Mustafa0812/Sesame/docs/README.md

# Documentation

| Folder / file | Contents |
|---|---|
| [build-guide/](build-guide/README.md) | Step-by-step mechanical assembly with photos (upstream Sesame) |
| [wiring-guide/](wiring-guide/README.md) | Wiring diagrams for the S2 Mini and Distro Board builds (upstream Sesame) |
| [motor-testing/](motor-testing/README.md) | Testing each servo and calibrating the hip joints before final assembly |
| [esp32-s3-supermini/](esp32-s3-supermini/README.md) | Porting notes for the ESP32-S3 SuperMini used by the two-bot setup: corrected pinout, calibration, bench findings |
| [images/](images/) | Project photos, face renders, and the ground-station dashboard screenshot (`images/two-bot/`) |
| [Sesame-Robots.pdf](Sesame-Robots.pdf) | Project write-up: two Sesame robots as communicating state machines |
