Mustafa0812/Sesame/docs/images/two-bot/before-head-extension.jpeg

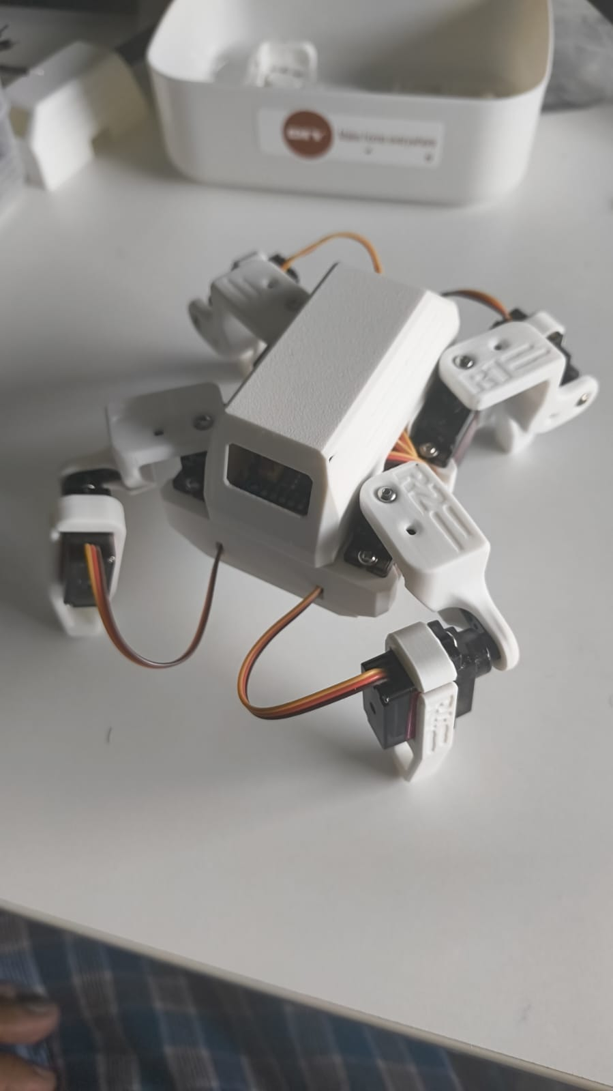
docs/images/two-bot/before-head-extension.jpeg
