Mustafa0812/Sesame/docs/images/two-bot/wiring-dilemma.jpeg

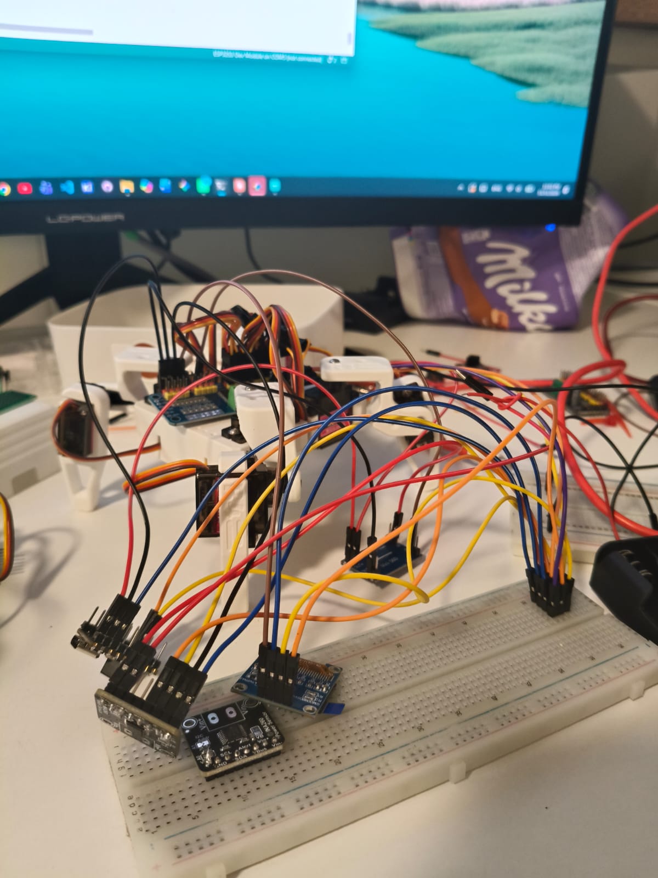
docs/images/two-bot/wiring-dilemma.jpeg
