Mustafa0812/Sesame/firmware/sesame-firmware-main/movement-sequences.h

#pragma once

#include <Arduino.h>

enum ServoName : uint8_t {
  R1 = 0, 
  R2 = 1,
  L1 = 2,
  L2 = 3,
  R3 = 4,
  R4 = 5,
  L4 = 6,
  L3 = 7
};

const String ServoNames[]={"R1","R2","L1","L2","R3","R4","L4","L3"};

inline int servoNameToIndex(const String& servo) {
  if (servo == "L1") return L1;
  if (servo == "L2") return L2;
  if (servo == "L3") return L3;
  if (servo == "L4") return L4;
  if (servo == "R1") return R1;
  if (servo == "R2") return R2;
  if (servo == "R3") return R3;
  if (servo == "R4") return R4;
  return -1;
}

enum FaceAnimMode : uint8_t {
  FACE_ANIM_LOOP = 0,
  FACE_ANIM_ONCE = 1,
  FACE_ANIM_BOOMERANG = 2
};

// External globals and helpers used by movement/pose sequences
extern int frameDelay;
extern int walkCycles;
extern String currentCommand;

extern void setServoAngle(uint8_t channel, int angle);
extern void setFace(const String& faceName);
extern void setFaceMode(FaceAnimMode mode);
extern void setFaceWithMode(const String& faceName, FaceAnimMode mode);
extern void delayWithFace(unsigned long ms);
extern void enterIdle();
extern bool pressingCheck(String cmd, int ms);

// Pose/animation prototypes
void runRestPose();
void runStandPose(int face = 1);
void runWavePose();
void runDancePose();
void runSwimPose();
void runPointPose();
void runPushupPose();
void runBowPose();
void runCutePose();
void runFreakyPose();
void runWormPose();
void runShakePose();
void runShrugPose();
void runDeadPose();
void runCrabPose();
void runWalkPose();
void runWalkBackward();
void runTurnLeft();
void runTurnRight();

// ====== POSES ======
inline void runRestPose() { 
  Serial.println(F("REST")); 
  setFaceWithMode("rest", FACE_ANIM_BOOMERANG); 
  for (int i = 0; i < 8; i++) setServoAngle(i, 90); 
}

inline void runStandPose(int face) { 
  Serial.println(F("STAND")); 
  if (face == 1) setFaceWithMode("stand", FACE_ANIM_ONCE); 
  setServoAngle(R1, 135); 
  setServoAngle(R2, 45); 
  setServoAngle(L1, 45); 
  setServoAngle(L2, 135); 
  setServoAngle(R3, 0); 
  setServoAngle(R4, 180); 
  setServoAngle(L4, 0); 
  setServoAngle(L3, 180); 
  if (face == 1) enterIdle();
}

inline void runWavePose() { 
  Serial.println(F("WAVE")); 
  setFaceWithMode("wave", FACE_ANIM_ONCE); 
  runStandPose(0); 
  delayWithFace(200);
  setServoAngle(L3, 100); setServoAngle(R4, 0);   // R4 waves, L3 holds one position
  setServoAngle(L2, 90); // R1 stays in the stand pose (was: setServoAngle(R1, 100))
  delayWithFace(200);
  setServoAngle(R4, 0);
  delayWithFace(300);
  for (int i = 0; i < 4; i++) {
    setServoAngle(R4, 0); delayWithFace(300);
    setServoAngle(R4, 80); delayWithFace(300);
  }
  runStandPose(1); 
  if (currentCommand == "wave") currentCommand = "";
}

inline void runDancePose() { 
  Serial.println(F("DANCE")); 
  setFaceWithMode("dance", FACE_ANIM_LOOP); 
  setServoAngle(R1, 90); setServoAngle(R2, 90); 
  setServoAngle(L1, 90); setServoAngle(L2, 90); 
  setServoAngle(R3, 160); setServoAngle(R4, 160); 
  setServoAngle(L4, 10); setServoAngle(L3, 10); 
  delayWithFace(300); 
  for (int i = 0; i < 5; i++) { 
    setServoAngle(R3, 115); setServoAngle(R4, 115); 
    setServoAngle(L4, 10); setServoAngle(L3, 10); 
    delayWithFace(300); 
    setServoAngle(R3, 160); setServoAngle(R4, 160); 
    setServoAngle(L4, 65); setServoAngle(L3, 65); 
    delayWithFace(300); 
  } 
  runStandPose(1); 
  if (currentCommand == "dance") currentCommand = "";
}

inline void runSwimPose() { 
  Serial.println(F("SWIM")); 
  setFaceWithMode("swim", FACE_ANIM_ONCE); 
  for (int i = 0; i < 8; i++) setServoAngle(i, 90); 
  for (int i = 0; i < 4; i++) { 
    setServoAngle(R1, 135); setServoAngle(R2, 45); 
    setServoAngle(L1, 45); setServoAngle(L2, 135); 
    delayWithFace(400); 
    setServoAngle(R1, 90); setServoAngle(R2, 90); 
    setServoAngle(L1, 90); setServoAngle(L2, 90); 
    delayWithFace(400); 
  } 
  runStandPose(1); 
  if (currentCommand == "swim") currentCommand = "";
}

inline void runPointPose() { 
  Serial.println(F("POINT")); 
  setFaceWithMode("point", FACE_ANIM_BOOMERANG); 
  setServoAngle(L2, 90); setServoAngle(R1, 135); 
  setServoAngle(R2, 100); setServoAngle(L3, 180); 
  setServoAngle(L1, 25); setServoAngle(L4, 145);
  setServoAngle(R3, 80); setServoAngle(R4, 170); 
  delayWithFace(2000); 
  runStandPose(1); 
  if (currentCommand == "point") currentCommand = "";
}

inline void runPushupPose() {
  Serial.println(F("PUSHUP"));
  setFaceWithMode("pushup", FACE_ANIM_ONCE);
  runStandPose(0); 
  delayWithFace(200);
  setServoAngle(L1, 0);
  setServoAngle(R1, 180);
  setServoAngle(R3, 90);
  setServoAngle(R4, 90);
  delayWithFace(500);
  for (int i = 0; i < 4; i++) {
    setServoAngle(R3, 0);
    setServoAngle(R4, 180);
    delayWithFace(600);
    setServoAngle(R3, 90);
    setServoAngle(R4, 90);
    delayWithFace(500);
  }
  runStandPose(1);
  if (currentCommand == "pushup") currentCommand = "";
}

inline void runBowPose() {
  Serial.println(F("BOW"));
  setFaceWithMode("bow", FACE_ANIM_ONCE);
  runStandPose(0); 
  delayWithFace(200);
  setServoAngle(L1, 0);
  setServoAngle(R1, 180);
  setServoAngle(L4, 0);
  setServoAngle(R4, 180);
  setServoAngle(L2, 180);
  setServoAngle(R2, 0);
  setServoAngle(R3, 0);
  setServoAngle(L3, 180);
  delayWithFace(600);
  setServoAngle(L4, 90);
  setServoAngle(R4, 90);
  delayWithFace(3000);
  runStandPose(1);
  if (currentCommand == "bow") currentCommand = "";
}

inline void runCutePose() {
  Serial.println(F("CUTE"));
  setFaceWithMode("cute", FACE_ANIM_ONCE);
  runStandPose(0); 
  delayWithFace(200);
  setServoAngle(L2, 160);
  setServoAngle(R2, 20);
  setServoAngle(R3, 180);
  setServoAngle(L3, 0);

  setServoAngle(L1, 0);
  setServoAngle(R1, 180);
  setServoAngle(L4, 180);
  setServoAngle(R4, 0);
  delayWithFace(200);
  for (int i = 0; i < 5; i++) {
    setServoAngle(R3, 180);
    setServoAngle(L3, 45);
    delayWithFace(300);
    setServoAngle(R3, 135);
    setServoAngle(L3, 0);
    delayWithFace(300);
  }
  runStandPose(1);
  if (currentCommand == "cute") currentCommand = "";
}

inline void runFreakyPose() {
  Serial.println(F("FREAKY"));
  setFaceWithMode("freaky", FACE_ANIM_ONCE);
  runStandPose(0); 
  delayWithFace(200);
  setServoAngle(L1, 0);
  setServoAngle(R1, 180);
  setServoAngle(L2, 180);
  setServoAngle(R2, 0);
  setServoAngle(R3, 90);
  setServoAngle(R4, 0);
  delayWithFace(200);
  for (int i = 0; i < 3; i++) {
    setServoAngle(R4, 25);
    delayWithFace(400);
    setServoAngle(R4, 0);
    delayWithFace(400);
  }
  runStandPose(1);
  if (currentCommand == "freaky") currentCommand = "";
}

inline void runWormPose() {
  Serial.println(F("WORM"));
  setFaceWithMode("worm", FACE_ANIM_ONCE);
  runStandPose(0);
  delayWithFace(200);
  setServoAngle(R1, 180); setServoAngle(R2, 0); setServoAngle(L1, 0); setServoAngle(L2, 180);
  setServoAngle(R3, 90); setServoAngle(R4, 90); setServoAngle(L4, 90); setServoAngle(L3, 90);
  delayWithFace(200);
  for(int i=0; i<5; i++) {
    setServoAngle(R4, 45); setServoAngle(L4, 135); setServoAngle(R3, 45); setServoAngle(L3, 135);
    delayWithFace(300);
    setServoAngle(R4, 135); setServoAngle(L4, 45); setServoAngle(R3, 135); setServoAngle(L3, 45);
    delayWithFace(300);
  }
  runStandPose(1);
  if (currentCommand == "worm") currentCommand = "";
}

inline void runShakePose() {
  Serial.println(F("SHAKE"));
  setFaceWithMode("shake", FACE_ANIM_ONCE);
  runStandPose(0);
  delayWithFace(200);
  setServoAngle(R1, 135); setServoAngle(L1, 45); setServoAngle(L4, 90); setServoAngle(R4, 90);
  setServoAngle(L2, 90); setServoAngle(R2, 90);
  delayWithFace(200);
  for(int i=0; i<5; i++) {
    setServoAngle(R3, 45); setServoAngle(L3, 135);
    delayWithFace(300);
    setServoAngle(R3, 0); setServoAngle(L3, 180);
    delayWithFace(300);
  }
  runStandPose(1);
  if (currentCommand == "shake") currentCommand = "";
}

inline void runShrugPose() {
  Serial.println(F("SHRUG"));
  runStandPose(0);
  setFaceWithMode("dead", FACE_ANIM_ONCE);
  delayWithFace(200);
  setServoAngle(R4, 90); setServoAngle(R3, 90); setServoAngle(L4, 90); setServoAngle(L3, 90);
  delayWithFace(1000);
  setFaceWithMode("shrug", FACE_ANIM_ONCE);
  setServoAngle(R4, 0); setServoAngle(R3, 180); setServoAngle(L4, 180); setServoAngle(L3, 0);
  delayWithFace(1500);
  runStandPose(1);
  if (currentCommand == "shrug") currentCommand = "";
}

inline void runDeadPose() {
  Serial.println(F("DEAD"));
  runStandPose(0);
  setFaceWithMode("dead", FACE_ANIM_BOOMERANG);
  delayWithFace(200);
  setServoAngle(R4, 90); setServoAngle(R3, 90); setServoAngle(L4, 90); setServoAngle(L3, 90);
  if (currentCommand == "dead") currentCommand = "";
}

inline void runCrabPose() {
  Serial.println(F("CRAB"));
  setFaceWithMode("crab", FACE_ANIM_ONCE);
  runStandPose(0);
  delayWithFace(200);
  setServoAngle(R1, 90); setServoAngle(R2, 90); setServoAngle(L1, 90); setServoAngle(L2, 90);
  setServoAngle(R3, 0); setServoAngle(R4, 180); setServoAngle(L4, 45); setServoAngle(L3, 135);
  for(int i=0; i<5; i++) {
    setServoAngle(R3, 45); setServoAngle(R4, 135); setServoAngle(L4, 0); setServoAngle(L3, 180);
    delayWithFace(300);
    setServoAngle(R3, 0); setServoAngle(R4, 180); setServoAngle(L4, 45); setServoAngle(L3, 135);
    delayWithFace(300);
  }
  runStandPose(1);
  if (currentCommand == "crab") currentCommand = "";
}

// --- MOVEMENT ANIMATIONS ---
inline void runWalkBackward() {
  Serial.println(F("WALK BACK"));
  setFaceWithMode("walk", FACE_ANIM_ONCE);
  // Initial Step
  setServoAngle(R4, 135); setServoAngle(L4, 45);
  setServoAngle(R2, 100); setServoAngle(L1, 25);
  if (!pressingCheck("backward", frameDelay)) return;
  
  for (int i = 0; i < walkCycles; i++) {
    setServoAngle(R4, 135); setServoAngle(L4, 0);
    if (!pressingCheck("backward", frameDelay)) return;
    setServoAngle(L3, 135); setServoAngle(L2, 90);
    setServoAngle(R3, 0); setServoAngle(R1, 180);
    if (!pressingCheck("backward", frameDelay)) return;    
    setServoAngle(R2, 45); setServoAngle(L1, 90);
    if (!pressingCheck("backward", frameDelay)) return;
    setServoAngle(R3, 45); setServoAngle(L3, 180);
    if (!pressingCheck("backward", frameDelay)) return;
    setServoAngle(R4, 180); setServoAngle(L4, 45);
    setServoAngle(R2, 90); setServoAngle(L1, 0);
    if (!pressingCheck("backward", frameDelay)) return;  
    setServoAngle(L2, 135); setServoAngle(R1, 90);
    if (!pressingCheck("backward", frameDelay)) return;
  }
  runStandPose(1);
}

// Function names swapped with the other walk: this body (runWalkPose) is the one that moves the robot forward
inline void runWalkPose() {
  Serial.println(F("WALK FWD"));
  setFaceWithMode("walk", FACE_ANIM_ONCE);
  if (!pressingCheck("forward", frameDelay)) return;
  
  for (int i = 0; i < walkCycles; i++) {
    setServoAngle(R4, 135); setServoAngle(L4, 0);
    if (!pressingCheck("forward", frameDelay)) return;
    setServoAngle(L3, 135); setServoAngle(L2, 135);
    setServoAngle(R3, 0); setServoAngle(R1, 90);
    if (!pressingCheck("forward", frameDelay)) return;    
    setServoAngle(R2, 90); setServoAngle(L1, 0);
    if (!pressingCheck("forward", frameDelay)) return;
    setServoAngle(R3, 45); setServoAngle(L3, 180);
    if (!pressingCheck("forward", frameDelay)) return;
    setServoAngle(R4, 180); setServoAngle(L4, 45);
    setServoAngle(R2, 45); setServoAngle(L1, 90);
    if (!pressingCheck("forward", frameDelay)) return;  
    setServoAngle(L2, 90); setServoAngle(R1, 180);
    if (!pressingCheck("forward", frameDelay)) return;
  }
  runStandPose(1);
}

// Simple turn logic
inline void runTurnRight() {
  Serial.println(F("TURN RIGHT"));
  setFaceWithMode("walk", FACE_ANIM_ONCE);
  for (int i = 0; i < walkCycles; i++) {
    //legset 1 (R1 L2)
    setServoAngle(R4, 135); setServoAngle(L3, 135); 
    if (!pressingCheck("right", frameDelay)) return;
    setServoAngle(R1, 180); setServoAngle(L2, 180); 
    if (!pressingCheck("right", frameDelay)) return;
    setServoAngle(R4, 180); setServoAngle(L3, 180); 
    if (!pressingCheck("right", frameDelay)) return;
    setServoAngle(R1, 135); setServoAngle(L2, 135);
    if (!pressingCheck("right", frameDelay)) return;
      //legset 2 (R2 L1)
    setServoAngle(R3, 45); setServoAngle(L4, 45); 
    if (!pressingCheck("right", frameDelay)) return;
    setServoAngle(R2, 90); setServoAngle(L1, 90); 
    if (!pressingCheck("right", frameDelay)) return;
    setServoAngle(R3, 0); setServoAngle(L4, 0); 
    if (!pressingCheck("right", frameDelay)) return;
    setServoAngle(R2, 45); setServoAngle(L1, 45);
    if (!pressingCheck("right", frameDelay)) return;  
  }
  runStandPose(1);
}

inline void runTurnLeft() {
  Serial.println(F("TURN LEFT"));
  setFaceWithMode("walk", FACE_ANIM_ONCE);
  for (int i = 0; i < walkCycles; i++) {
    //legset 2 (R2 L1)
    setServoAngle(R3, 45); setServoAngle(L4, 45); 
    if (!pressingCheck("left", frameDelay)) return;
    setServoAngle(R2, 0); setServoAngle(L1, 0); 
    if (!pressingCheck("left", frameDelay)) return;
    setServoAngle(R3, 0); setServoAngle(L4, 0); 
    if (!pressingCheck("left", frameDelay)) return;
    setServoAngle(R2, 45); setServoAngle(L1, 45);
    if (!pressingCheck("left", frameDelay)) return;  
    //legset 1 (R1 L2)
    setServoAngle(R4, 135); setServoAngle(L3, 135); 
    if (!pressingCheck("left", frameDelay)) return;
    setServoAngle(R1, 90); setServoAngle(L2, 90); 
    if (!pressingCheck("left", frameDelay)) return;
    setServoAngle(R4, 180); setServoAngle(L3, 180); 
    if (!pressingCheck("left", frameDelay)) return;
    setServoAngle(R1, 135); setServoAngle(L2, 135);
    if (!pressingCheck("left", frameDelay)) return;
  }
  runStandPose(1);
}
